hysdanny-lagrange/hanser-translucent-pcb/photos/pcb反面.jpg

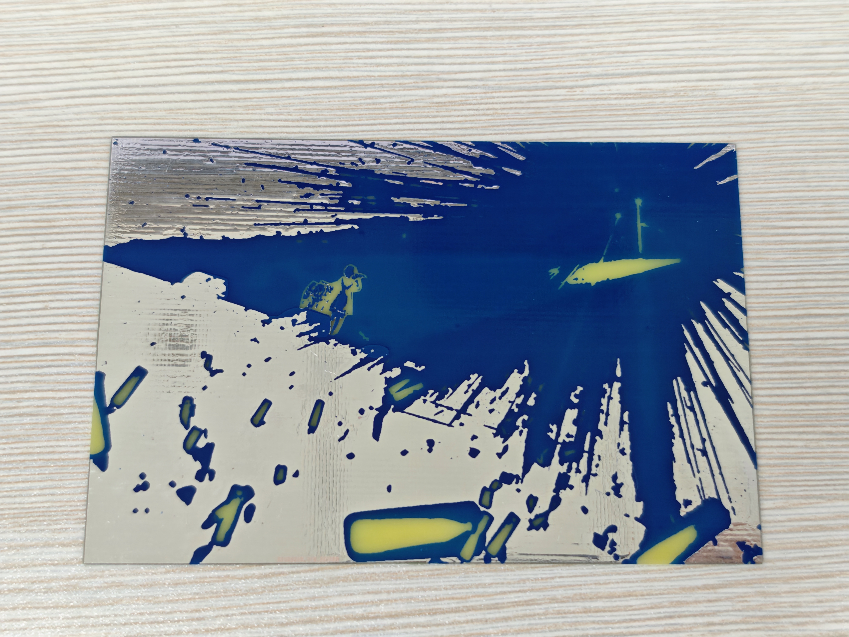
photos/pcb反面.jpg
