hysdanny-lagrange/hanser-translucent-pcb/photos/pcb正面.jpg

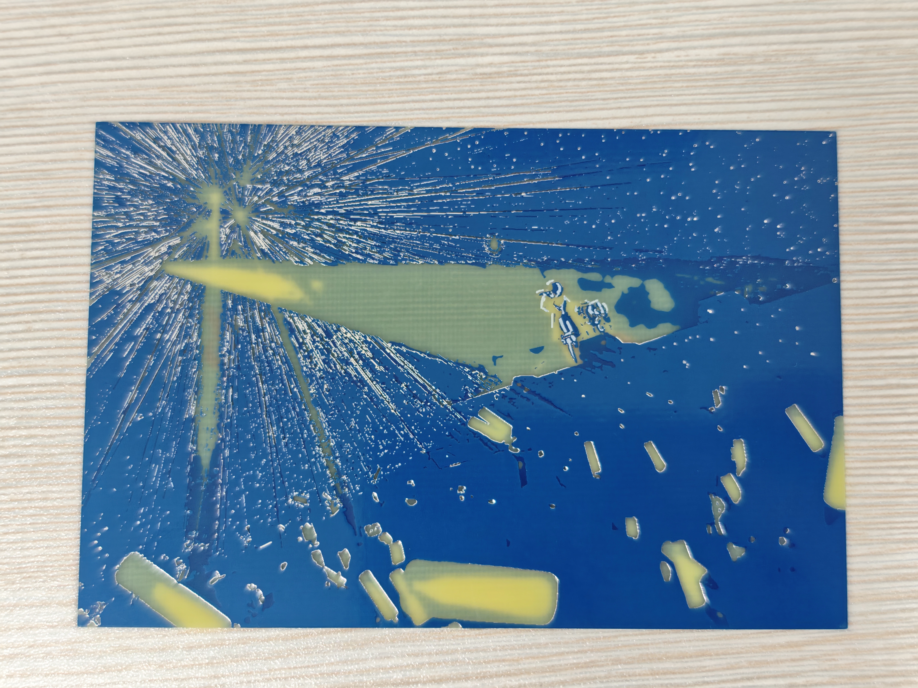
photos/pcb正面.jpg
