hysdanny-lagrange/hanser-translucent-pcb/photos/在室内使用白光的效果.jpg

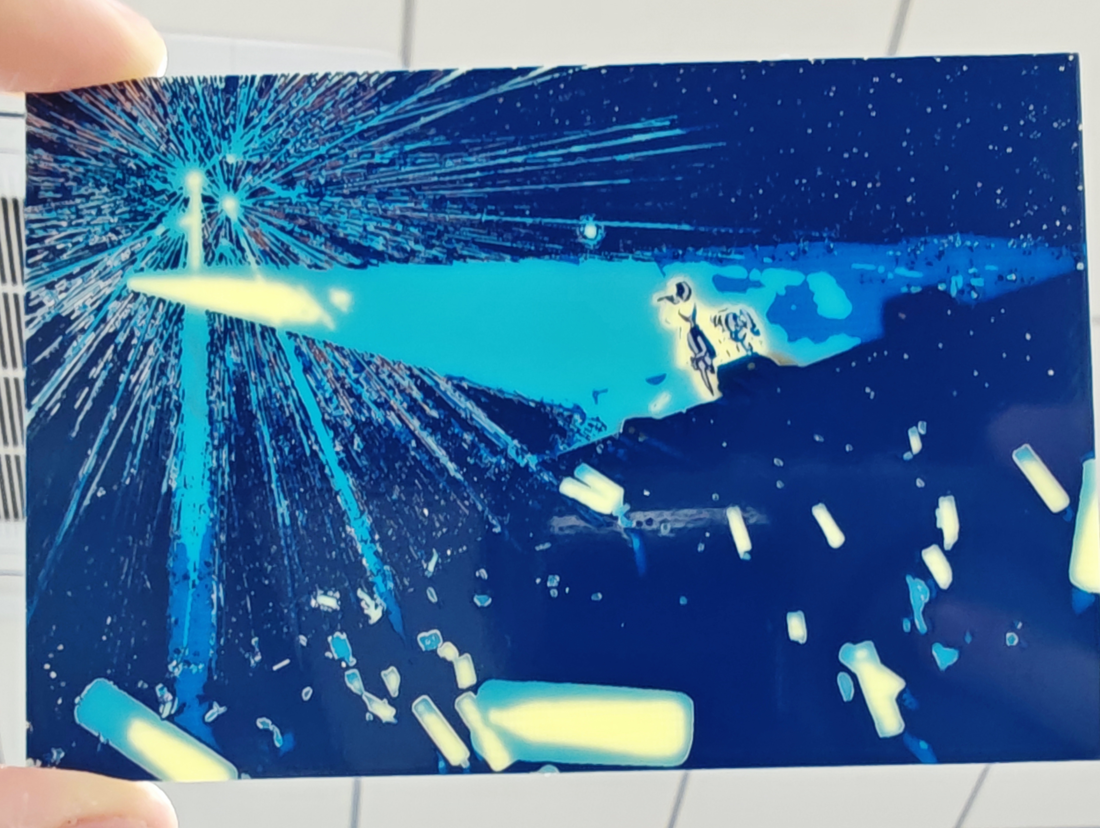
photos/在室内使用白光的效果.jpg
