hysdanny-lagrange/hanser-translucent-pcb/lightbox/pcb灯盒.STEP

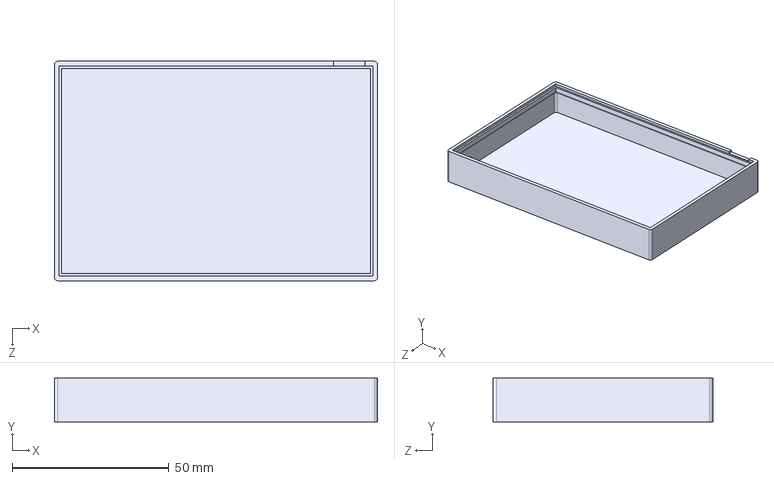
[picture p8: CAD file, 2026-11-01]
lightbox/pcb灯盒.STEP
103.0 x 14.0 x 70.0 mm
