hysdanny-lagrange/hanser-translucent-pcb/(commit log)

2026-11-01 Initialize yousa NFC PCB project
2026-11-01 Publish PCB source, four board packages, artwork and ordering guide
    [pcb灯盒.STEP]
2026-11-01 Format translucency description and document LED strip
